jmysu/R3Mkr12F/README.md

# R3Mkr12F
Arduino R3 w/ MKR w/ ESP-12F VaporWare 

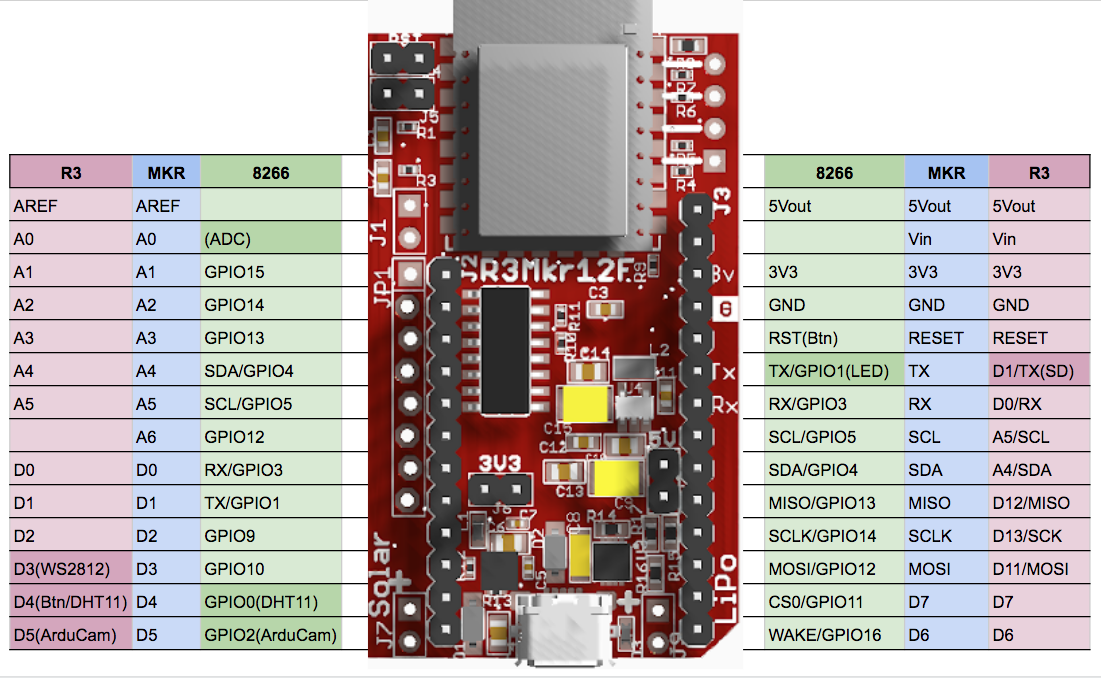
[picture p1: Documents/r3mkr12f_1.png]
R3Mkr12F Pinout

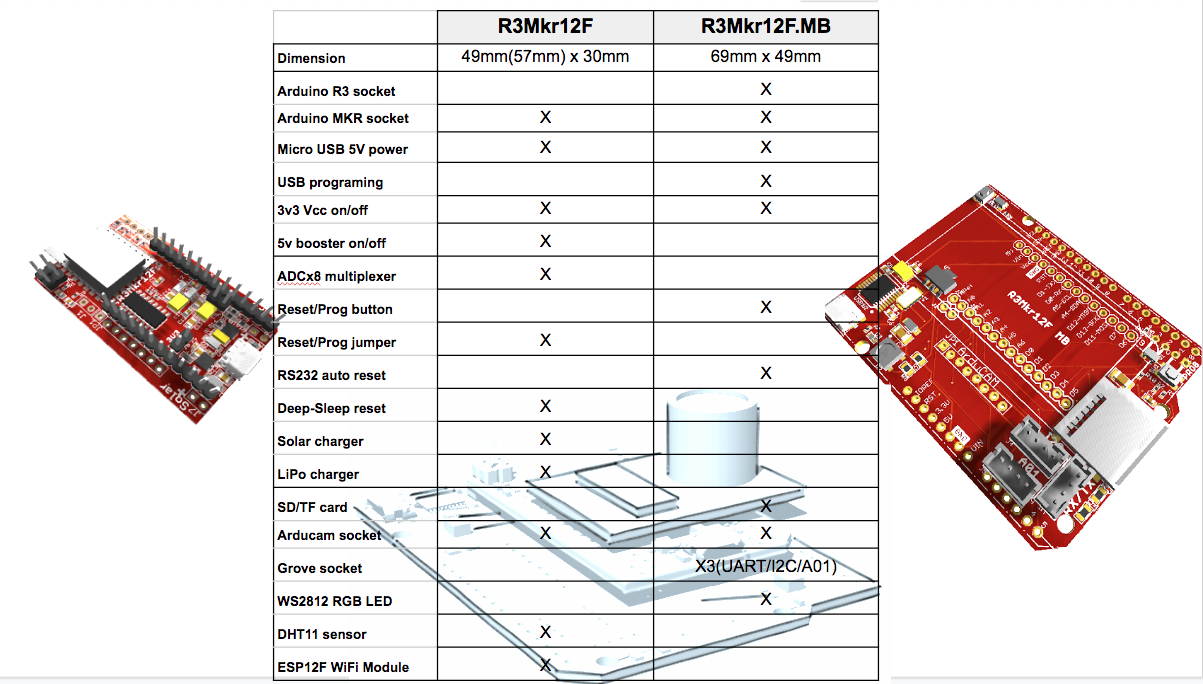
[picture p2: Documents/r3mkr12f_2.png]
R3Mkr12F Feature
