jmysu/R3Mkr12F/Hardware/DOC/SW4235.pdf

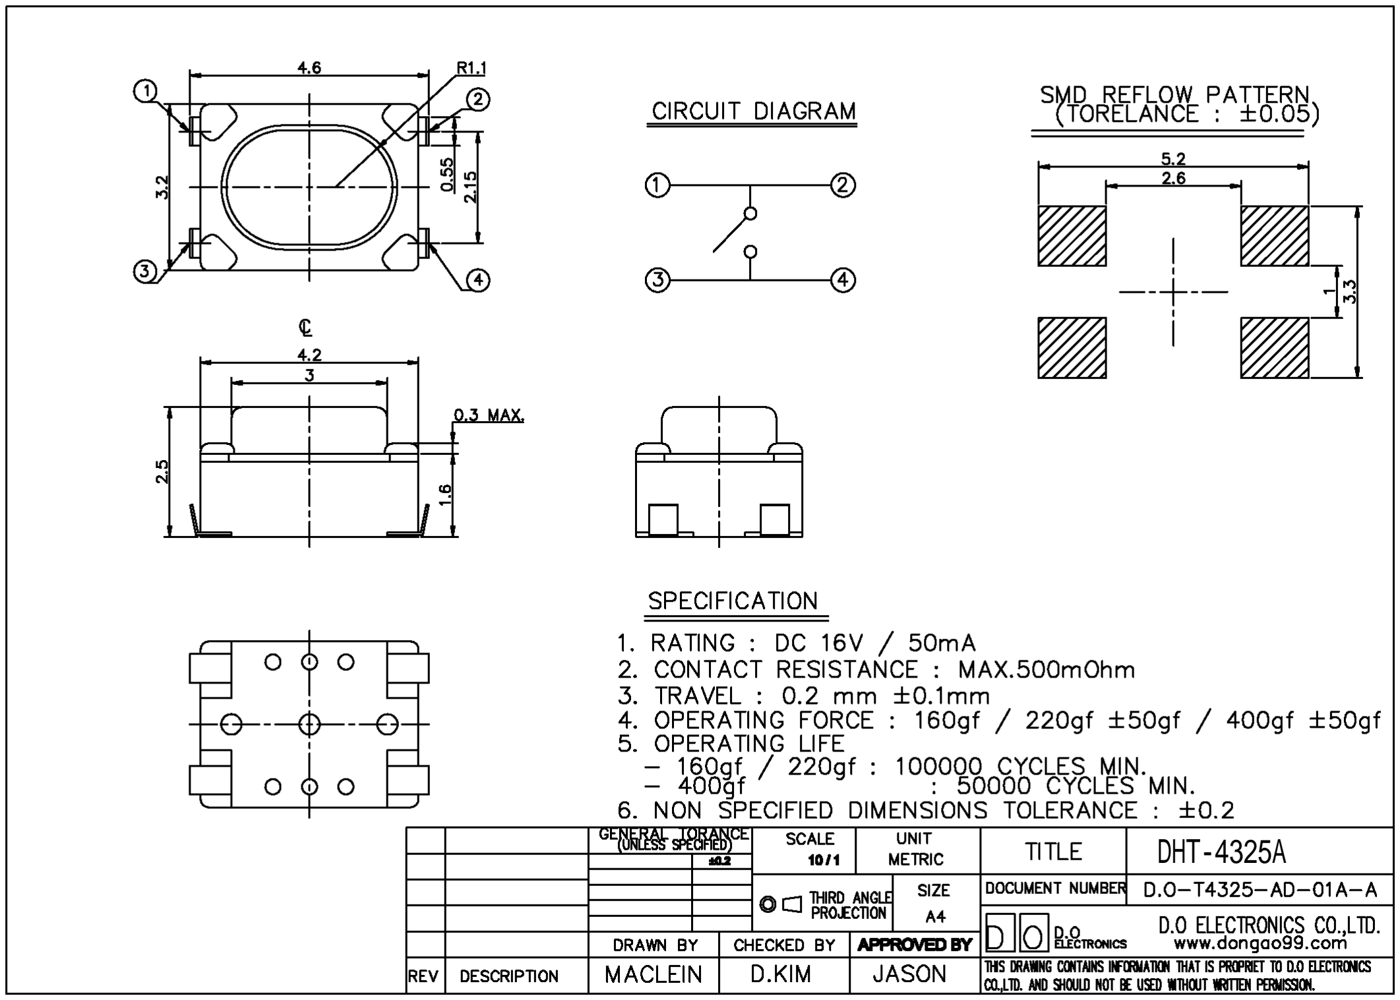
[picture p3: page 1]

REV I DESCRIPTlON

CIRCUIT DIAGRAM

SPECIFICATION
1. RATING : DC 16V / 50mA

SMD REFLOW PATTERN
CTORELANCE : :t0.051
2. CONTACT RESISTANCE : MAX.500mOhm
3. TRAVEL : 0.2
4. OPERA TI N G FORCE : 160gf / 220gf :t 50gf /
5. OPERATING Ll FE
I 220gf : 1 ' | - | : 50000 CYCLES MIN.
6. NON SPECIFIED DIMENSIONS TOLERANCE

DRAWN BY
MACLEIN
SCALE 1 | UNIT
1 METlRIC | TITLE
ANGLd | SIZE | T4325-AO-01 A-A
… | '
Ih 11"lno | D.O ELEClRONICS CO.,LlD.
BY I
D.K1M I JASON
