jmysu/R3Mkr12F/Hardware/DOC/R3Mkr12F_ArduCam.jpg

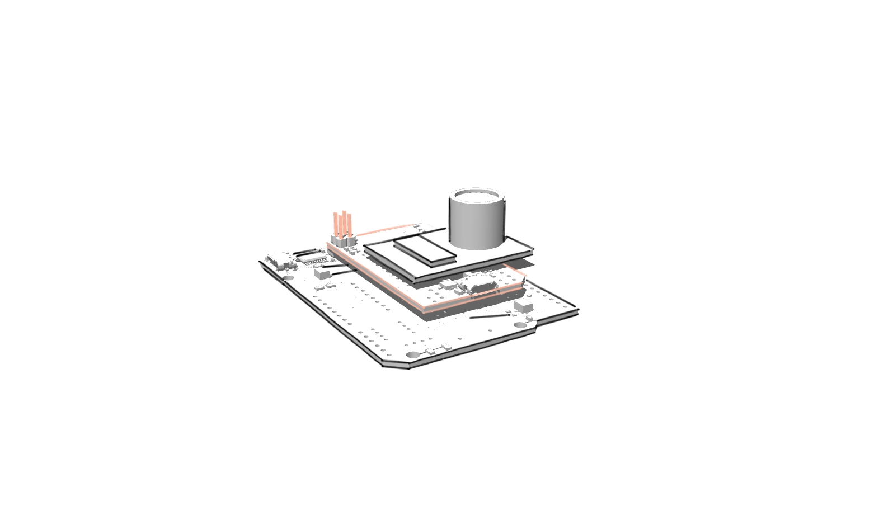
Hardware/DOC/R3Mkr12F_ArduCam.jpg
