jmysu/R3Mkr12F/Hardware/DOC/R3Mkr12F_MB_.png

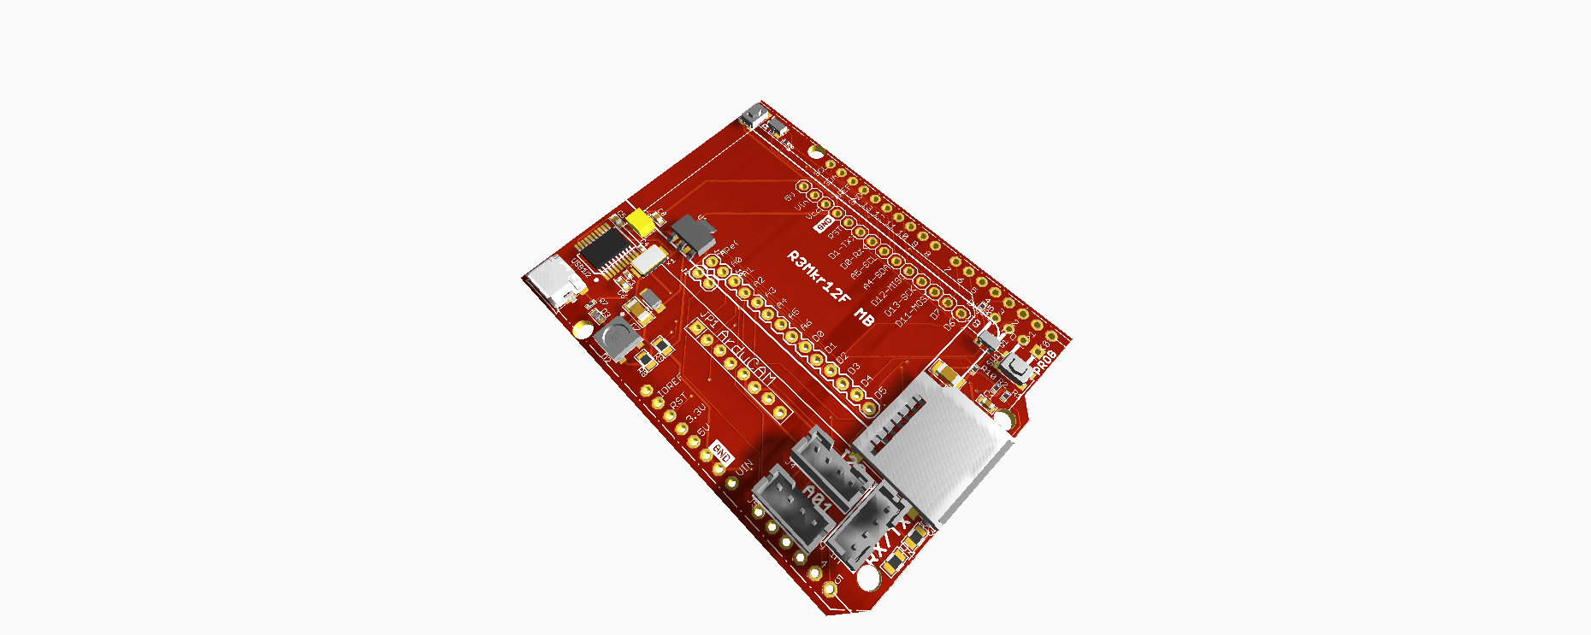
Hardware/DOC/R3Mkr12F_MB_.png
