jmysu/R3Mkr12F/Hardware/R3Mkr12F_Solar_Top.png

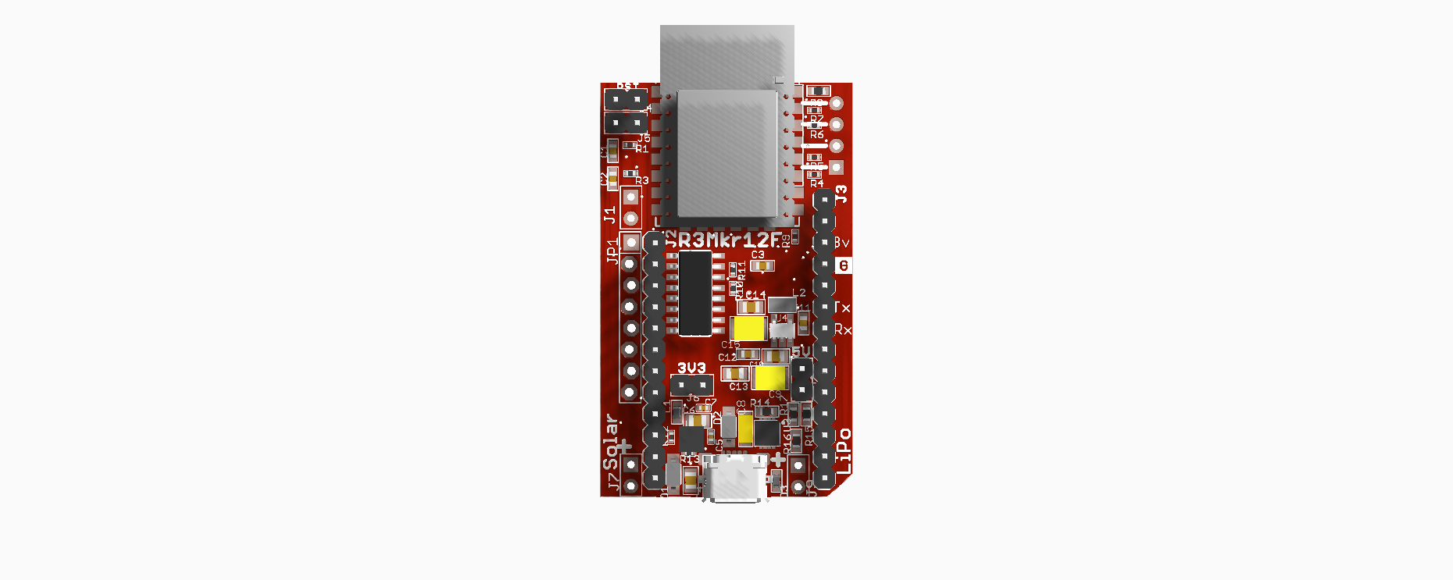
Hardware/R3Mkr12F_Solar_Top.png
