jmysu/R3Mkr12F/Hardware/DOC/dht22.stl

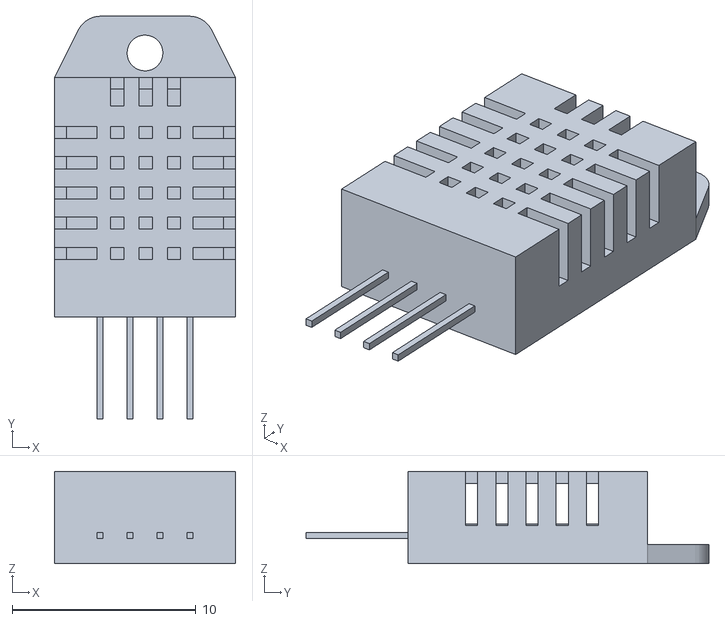
[picture p7: CAD file, 2019-06-03]
Hardware/DOC/dht22.stl
9.84 x 21.9 x 5.02
