jmysu/R3Mkr12F/Hardware/DOC/ArduCam.stl

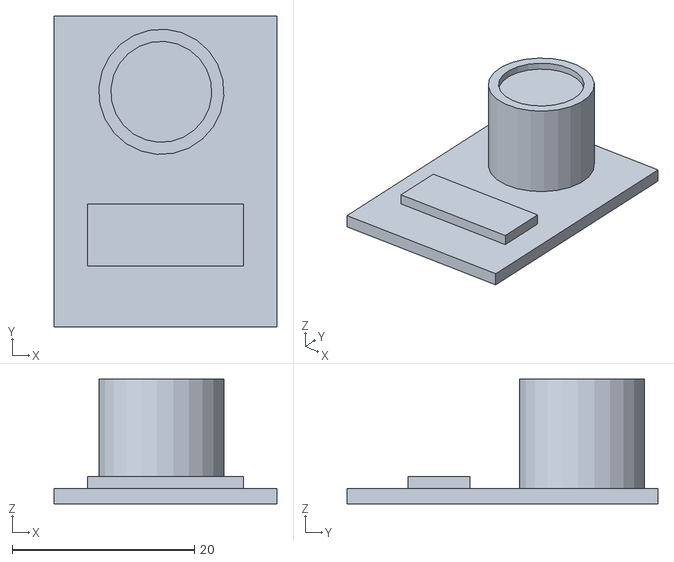
[picture p8: CAD file, 2019-06-03]
Hardware/DOC/ArduCam.stl
24.4 x 34.1 x 13.7
