jmysu/R3Mkr12F/(list of files, cad)

Other CAD files:
Hardware/DOC/R3Mkr12F_PV~.skp
