jmysu/R3Mkr12F/Hardware/R3Mkr12F_MB_.brd

## EAGLE design Hardware/R3Mkr12F_MB_.brd (2019-06-03)

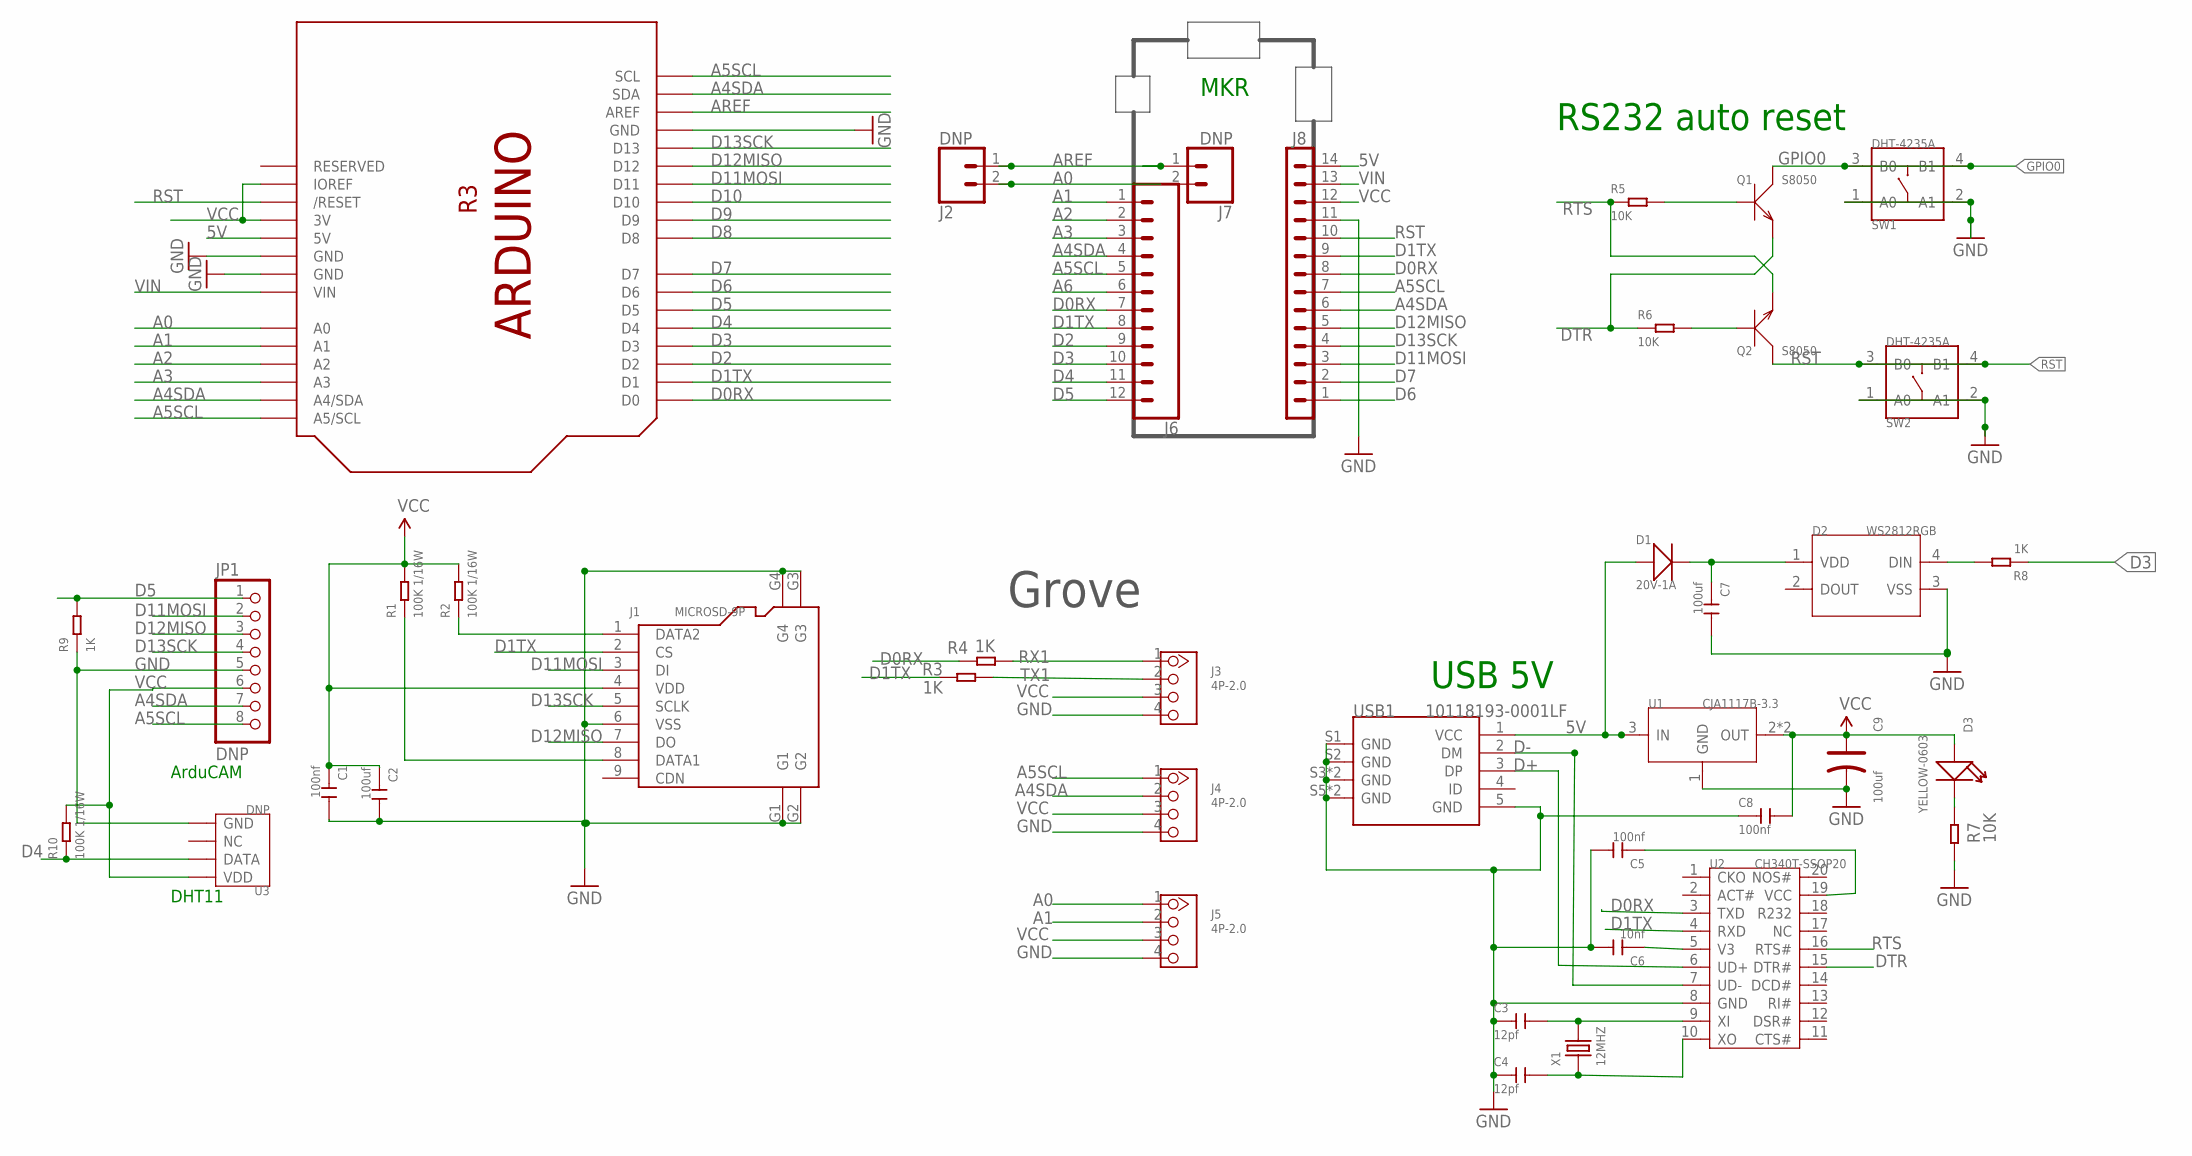
[picture p9: schematic R3Mkr12F_MB_.sch]

Parts:
C1, C5, C8: 100nf; C0603
C2, C7: 100uf; C1206
C3, C4: 12pf; C0402
C6: 10nf; C0603
C9: 100uf; AVX-B
D1: 20V-1A; SOD-123
D2: WS2812RGB; LED4-SMD-5050
D3: YELLOW-0603; LED-0603
J1: MICROSD-9P; MICRO-SD9+4P-SMD-16.1X14.5X1.85MM
J2, J7: DNP; 1X02
J3, J4, J5: 4P-2.0; HW4-2.0
J6: CONN_12LOCK; 1X12_LOCK
J8: DNP; 1X14
JP1: DNP; MILLER_1X08-LOCK
Q1, Q2: S8050; SOT-23
R1, R2, R10: 100K 1/16W; R0402
R3, R4, R8, R9: 1K; R0805
R5, R6, R7: 10K; R0402
SW1, SW2: DHT-4235A; SW4-SMD-4.2X3.2X2.5MM
U1: CJA1117B-3.3; SOT-89
U2: CH340T-SSOP20; SSOP20-0.65-7.6X5.2MM
U3: DNP; SNR4-2.54-15.5X12.0X5.5MM
UNO1: ARDUINO_R3_NOICSP_47MM; ARDUINOR3_NOICSP_47MM
USB1: 10118193-0001LF; MICRO-USB5+6P-SMD-0.65-B
X1: 12MHZ; X2-SMD-5.0X3.2X1.3MM

Connections:
5V: D1.+, J8.14, U1.3 (IN), UNO1.5V, USB1.1 (VCC)
A0: J2.2, J5.1, J7.2, UNO1.A0
A1: J5.2, J6.1, UNO1.A1
A2: J6.2, UNO1.A2
A3: J6.3, UNO1.A3
A4SDA: J4.2, J6.4, J8.6, JP1.7, UNO1.A4 (A4/SDA), UNO1.SDA
A5SCL: J4.1, J6.5, J8.7, JP1.8, UNO1.A5 (A5/SCL), UNO1.SCL
A6: J6.6
AREF: J2.1, J7.1, UNO1.AREF
D0RX: J6.7, J8.8, R4.2, U2.3 (TXD), UNO1.D0
D1TX: J1.2 (CS), J6.8, J8.9, R3.2, U2.4 (RXD), UNO1.D1
D2: J6.9, UNO1.D2
D3: J6.10, R8.1, UNO1.D3
D4: J6.11, R10.1, U3.2 (DATA), UNO1.D4
D5: J6.12, JP1.1, R9.2, UNO1.D5
D6: J8.1, UNO1.D6
D7: J8.2, UNO1.D7
D8: UNO1.D8
D9: UNO1.D9
D10: UNO1.D10
D11MOSI: J1.3 (DI), J8.3, JP1.2, UNO1.D11
D12MISO: J1.7 (DO), J8.5, JP1.3, UNO1.D12
D13SCK: J1.5 (SCLK), J8.4, JP1.4, UNO1.D13
D+: U2.6 (UD+), USB1.3 (DP)
D-: U2.7 (UD-), USB1.2 (DM)
DTR: Q1.2 (E), R6.1, U2.15 (DTR#)
GND: C1.2, C2.2, C3.1, C4.1, C5.2, C6.2, C7.2, C8.1, C9.-, D2.3 (VSS), J1.6 (VSS), J1.G1, J1.G2, J1.G3, J1.G4, J3.4, J4.4, J5.4, J8.11, JP1.5, R7.1, R9.1, SW1.1 (A0), SW1.2 (A1), SW2.1 (A0), SW2.2 (A1), U1.1 (GND), U2.8 (GND), U3.4 (GND), UNO1.GND, UNO1.GND@1 (GND), UNO1.GND@2 (GND), USB1.5 (GND), USB1.S1 (GND), USB1.S2 (GND), USB1.S3 (GND), USB1.S4 (GND), USB1.S5 (GND), USB1.S6 (GND)
GPIO0: Q1.3 (C), SW1.3 (B0), SW1.4 (B1)
unnamed: C3.2, U2.9 (XI), X1.2
unnamed: C4.2, U2.10 (XO), X1.1
unnamed: J1.8 (DATA1), R1.1
unnamed: J1.1 (DATA2), R2.1
unnamed: D2.4 (DIN), R8.2
unnamed: Q2.1 (B), R6.2
unnamed: Q1.1 (B), R5.2
unnamed: D3.-, R7.2
RST: J8.10, Q2.3 (C), SW2.3 (B0), SW2.4 (B1), UNO1.RESET (/RESET)
RTS: Q2.2 (E), R5.1, U2.16 (RTS#)
RX1: J3.1, R4.1
TX1: J3.2, R3.1
V1: C7.1, D1.-, D2.1 (VDD)
V3: C6.1, U2.5 (V3)
VCC: C1.1, C2.1, C5.1, C8.2, C9.+, D3.+, J1.4 (VDD), J3.3, J4.3, J5.3, J8.12, JP1.6, R1.2, R2.2, R10.2, U1.2 (OUT), U1.4 (OUT), U2.19 (VCC), U3.1 (VDD), UNO1.3V, UNO1.IOREF
VIN: J8.13, UNO1.VIN

Notes on the sheet:
Grove
USB 5V
RS232 auto reset
DHT11
ArduCAM
MKR

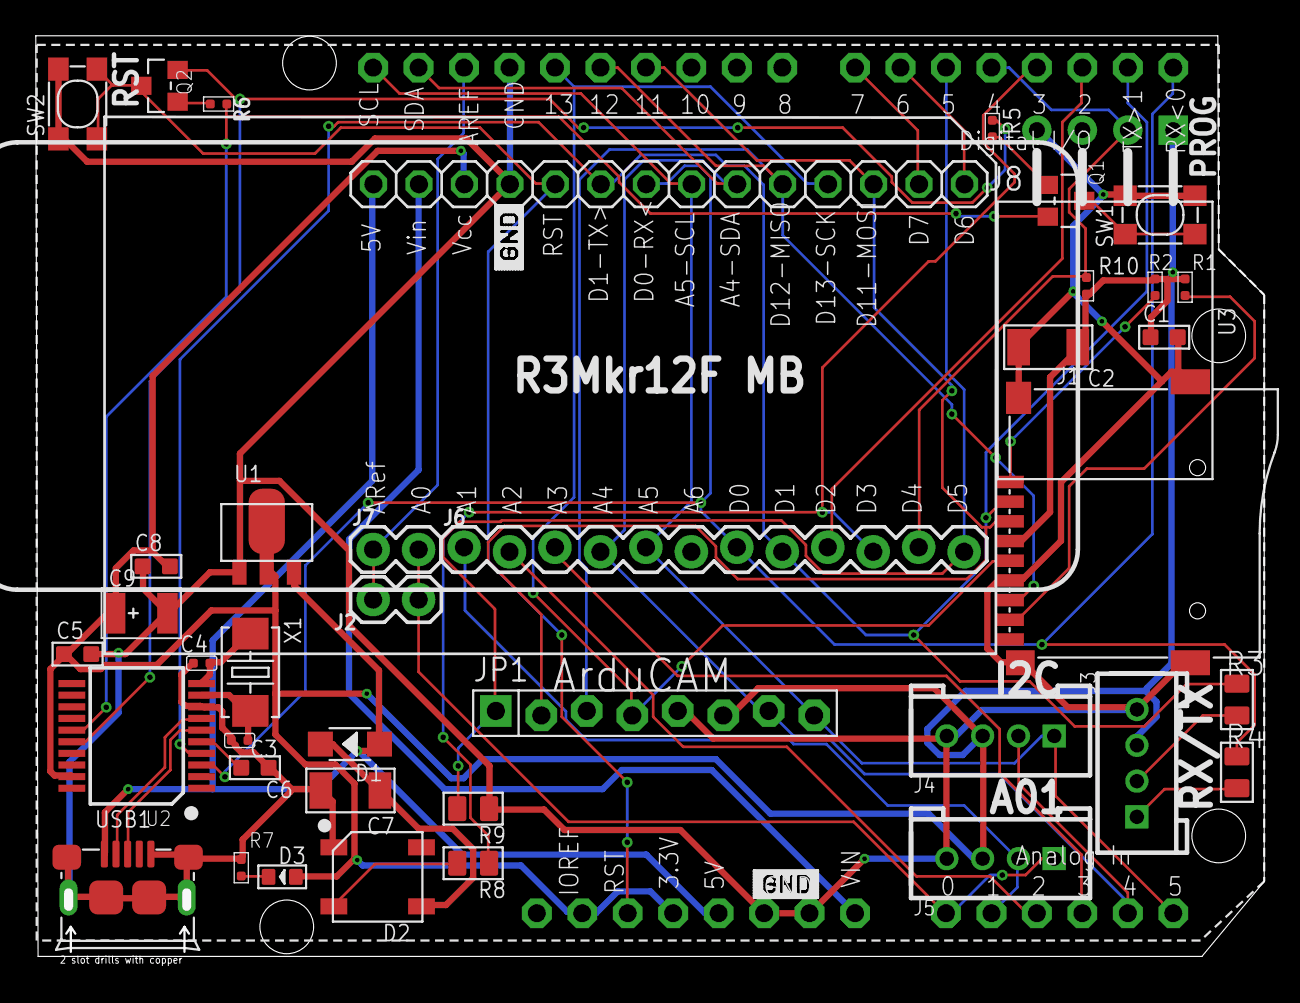
[picture p10: board R3Mkr12F_MB_.brd from above]

Board: 2 copper layers, 68.6 x 51.4 mm, 41 parts (0 on the bottom side), 40 nets.
