jmysu/R3Mkr12F/Hardware/R3Mkr12F_Solar.brd

## EAGLE design Hardware/R3Mkr12F_Solar.brd (2019-06-03)

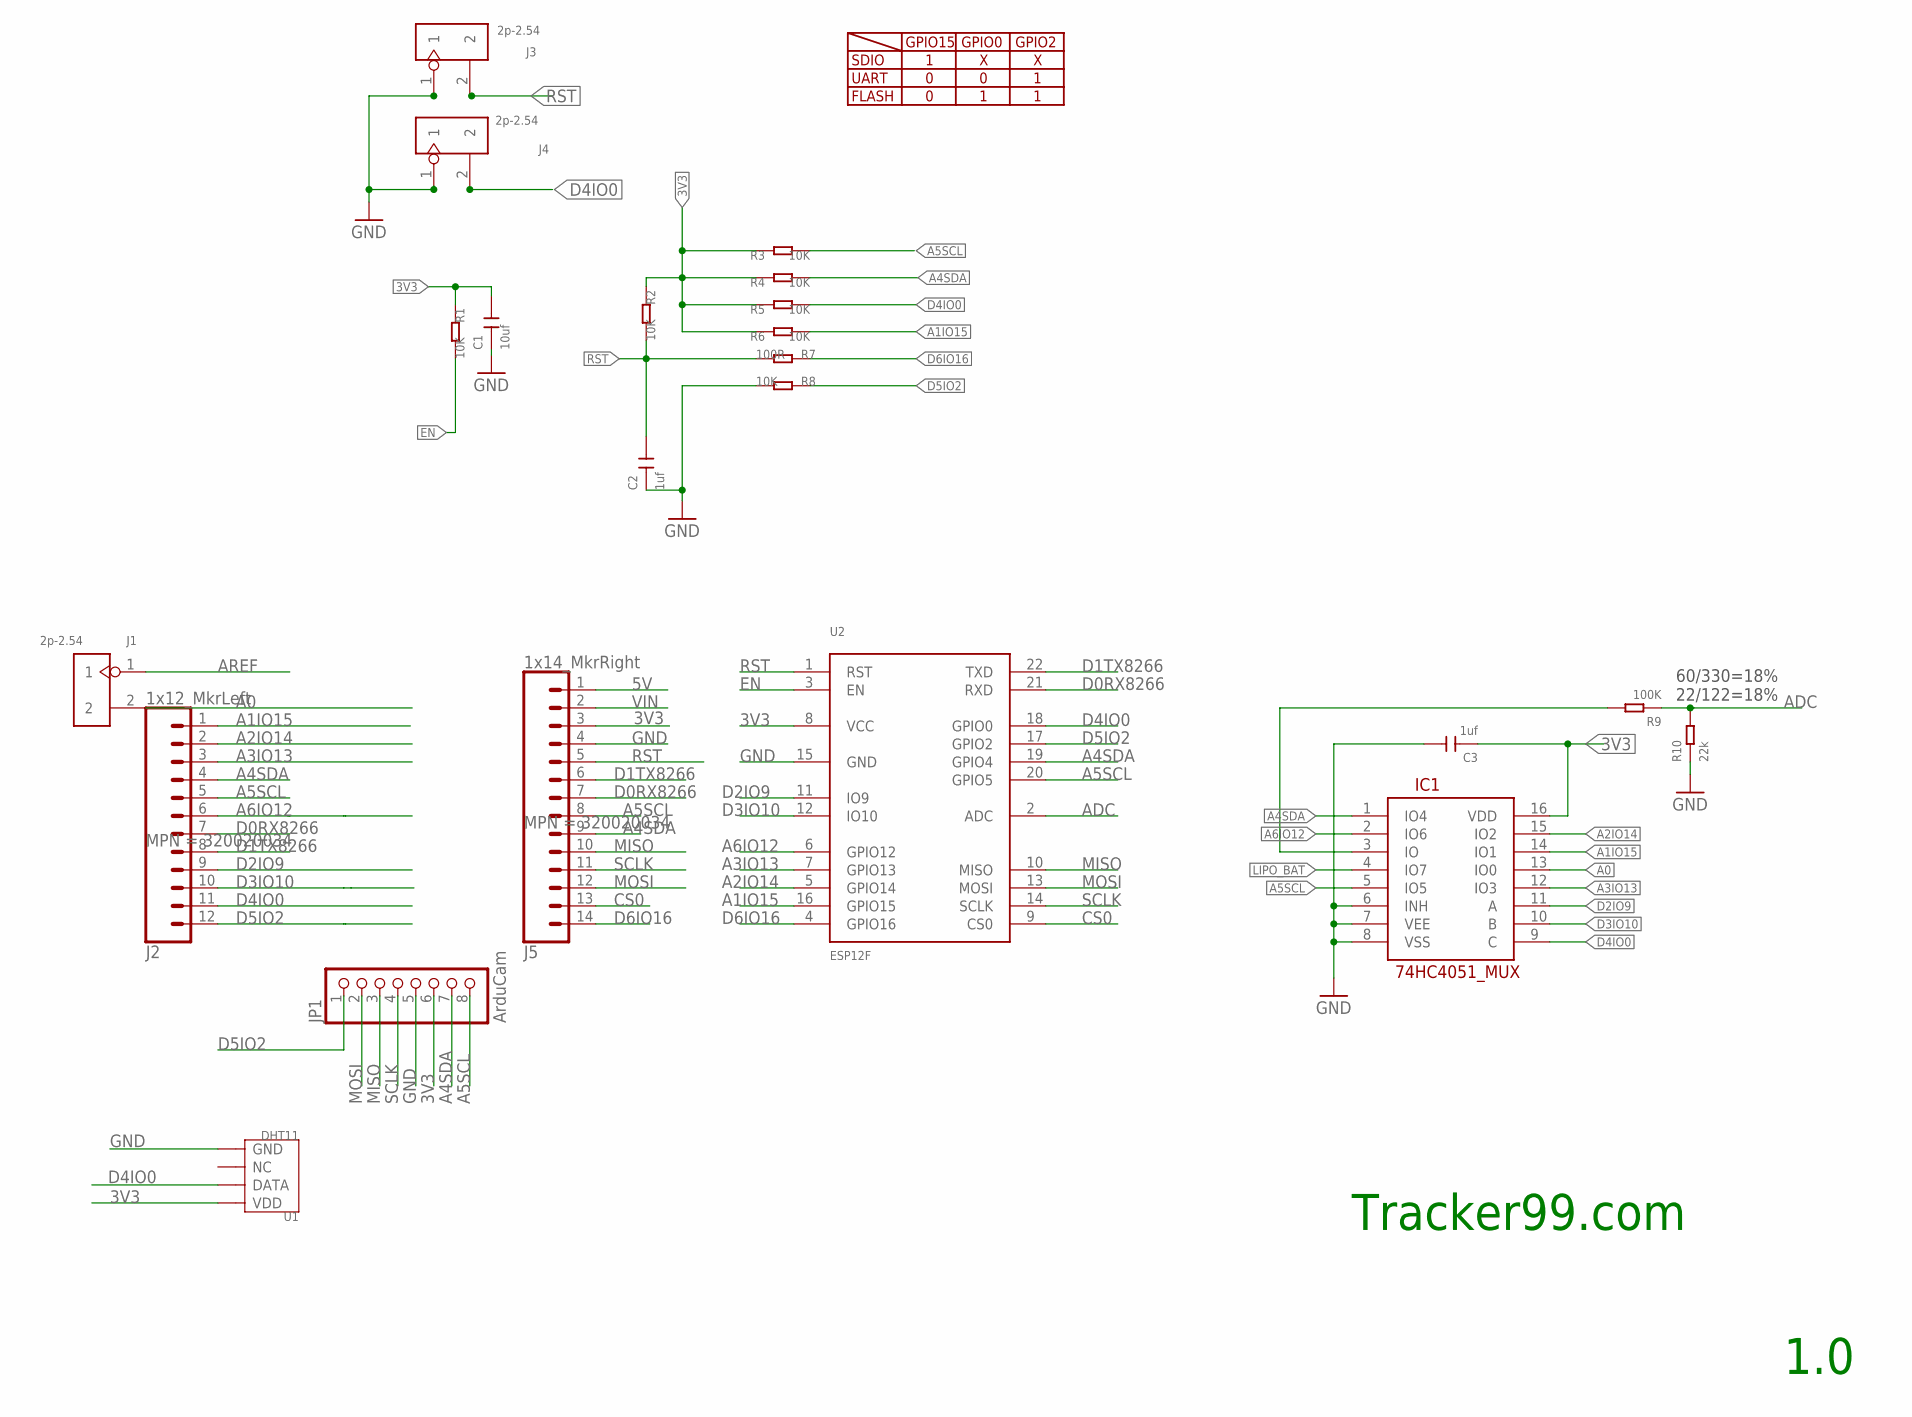
[picture p11: schematic R3Mkr12F_Solar.sch, sheet 1]

Parts:
C1: 10uf; C0603
C2, C3: 1uf; C0603
IC1: 74HC4051_MUX; SPARKFUN_SO16
J1, J3, J4: 2p-2.54; H2-2.54
J2: 1x12_MkrLeft; 1X12_LOCK; MPN 320020034
J5: 1x14_MkrRight; 1X14_LOCK; MPN 320020034
JP1: ArduCam; MILLER_1X08-LOCK
R1, R2, R3, R4, R5, R6, R8: 10K; SEEED-RESISTOR_R0402
R7: 100R; R0603
R9: 100K; R0402
R10: 22k; R0402
U1: DHT11; SNR4-2.54-15.5X12.0X5.5MM
U2: ESP12F; ESP-12F

Connections:
3V3: C1.2, C3.1, IC1.16 (VDD), J5.3, JP1.6, R1.1, R2.1, R3.1, R4.1, R5.1, R6.1, U1.1 (VDD), U2.8 (VCC); also elsewhere on the board
5V: J5.1; also elsewhere on the board
A0: IC1.13 (IO0), J1.2
A1IO15: IC1.14 (IO1), J2.1, R6.2, U2.16 (GPIO15)
A2IO14: IC1.15 (IO2), J2.2, U2.5 (GPIO14)
A3IO13: IC1.12 (IO3), J2.3, U2.7 (GPIO13)
A4SDA: IC1.1 (IO4), J2.4, J5.9, JP1.7, R4.2, U2.19 (GPIO4)
A5SCL: IC1.5 (IO5), J2.5, J5.8, JP1.8, R3.2, U2.20 (GPIO5)
A6IO12: IC1.2 (IO6), J2.6, U2.6 (GPIO12)
ADC: R9.1, R10.2, U2.2 (ADC)
AREF: J1.1
CS0: J5.13, U2.9 (CS0)
D0RX8266: J2.7, J5.7, U2.21 (RXD)
D1TX8266: J2.8, J5.6, U2.22 (TXD)
D2IO9: IC1.11 (A), J2.9, U2.11 (IO9)
D3IO10: IC1.10 (B), J2.10, U2.12 (IO10)
D4IO0: IC1.9 (C), J2.11, J4.2, R5.2, U1.2 (DATA), U2.18 (GPIO0)
D5IO2: J2.12, JP1.1, R8.1, U2.17 (GPIO2)
D6IO16: J5.14, R7.1, U2.4 (GPIO16)
EN: R1.2, U2.3 (EN)
GND: C1.1, C2.1, C3.2, IC1.6 (INH), IC1.7 (VEE), IC1.8 (VSS), J3.1, J4.1, J5.4, JP1.5, R8.2, R10.1, U1.4 (GND), U2.15 (GND); also elsewhere on the board
LIPO_BAT: IC1.4 (IO7); also elsewhere on the board
MISO: J5.10, JP1.3, U2.10 (MISO)
MOSI: J5.12, JP1.2, U2.13 (MOSI)
RST: C2.2, J3.2, J5.5, R2.2, R7.2, U2.1 (RST)
SCLK: J5.11, JP1.4, U2.14 (SCLK)
VIN: J5.2
Z: IC1.3 (IO), R9.2

Notes on the sheet:
SDIO
UART
FLASH
GPIO15
GPIO0
GPIO2
60/330=18% 22/122=18%
Tracker99.com
1.0

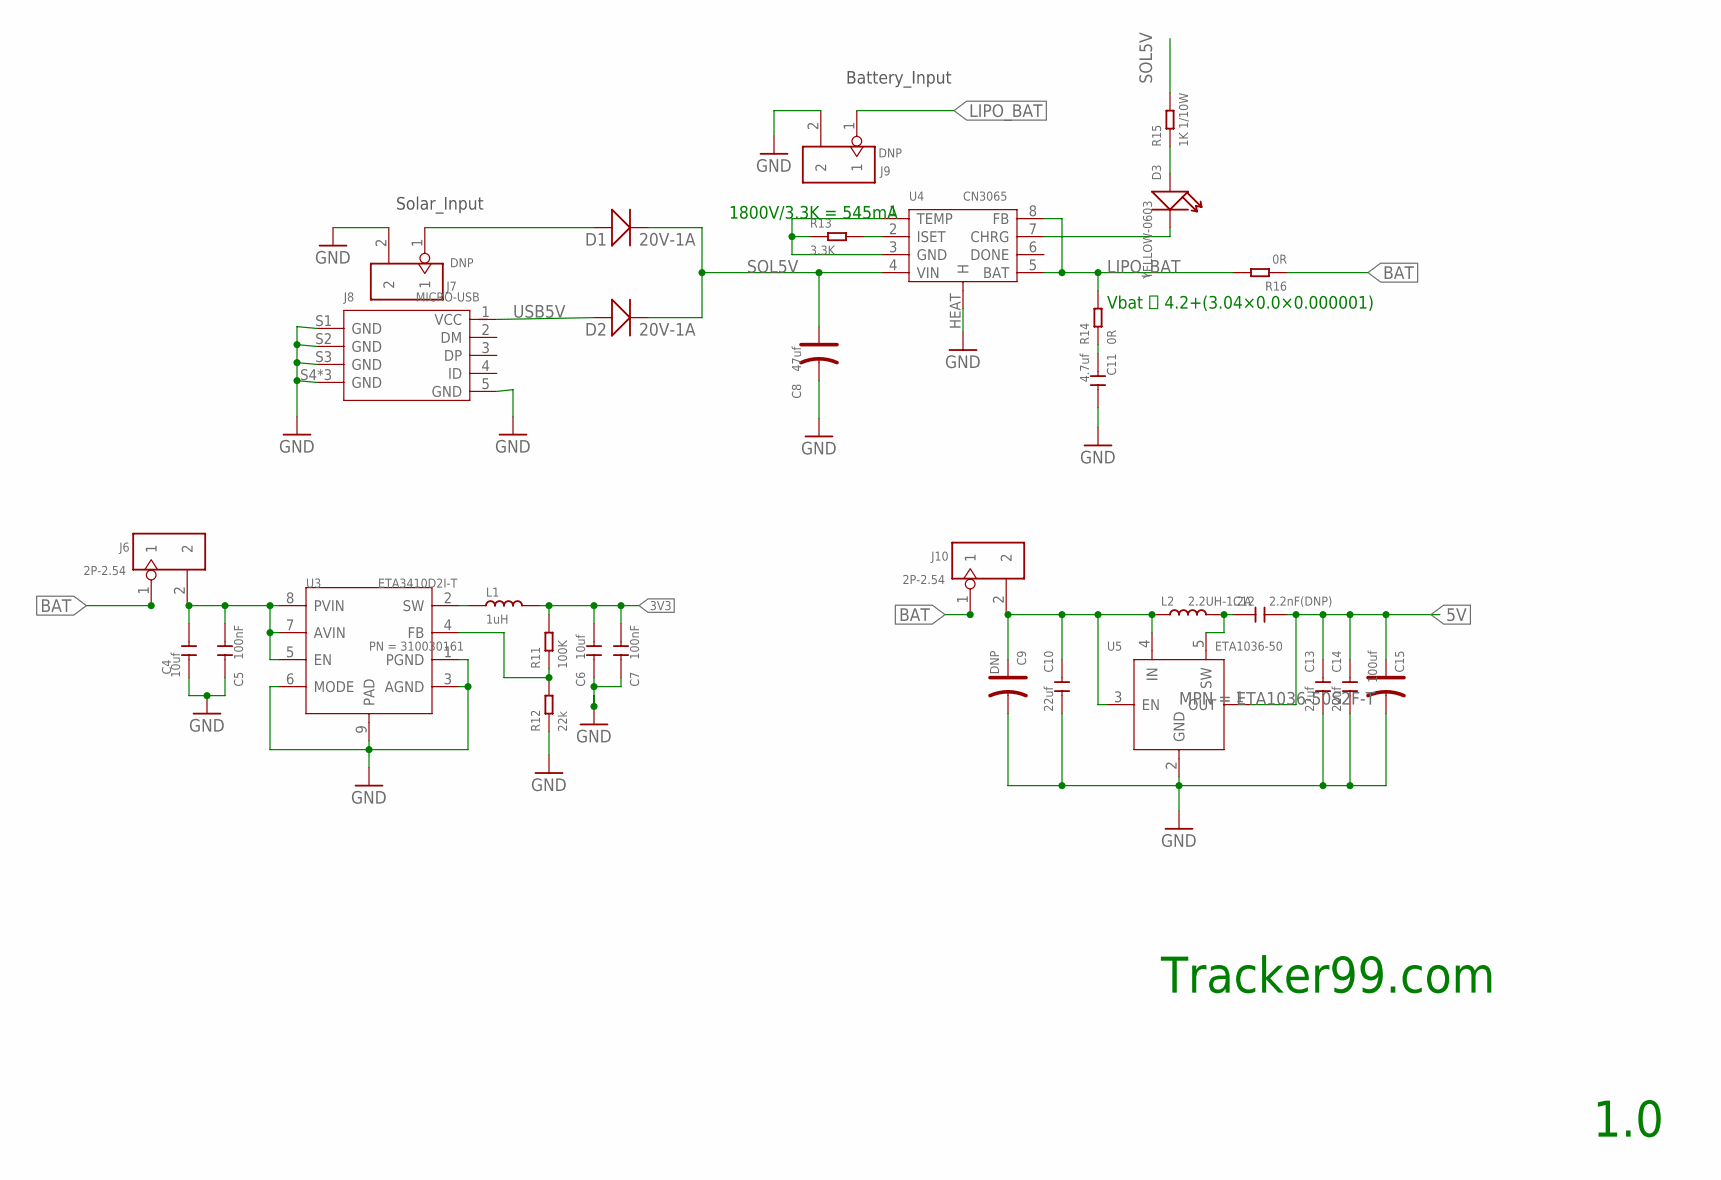
[picture p12: schematic R3Mkr12F_Solar.sch, sheet 2]

Parts:
C4, C6: 10uf; C0805
C5, C7: 100nF; C0402
C8: 47uf; AVX-A
C9: DNP; AVX-B
C10, C13, C14: 22uf; C0805
C11: 4.7uf; C0603
C12: 2.2nF(DNP); C0603
C15: 100uf; AVX-B
D1, D2: 20V-1A; SOD-123
D3: YELLOW-0603; LED-0603
J6, J10: 2P-2.54; H2-2.54
J7, J9: DNP; H2-2.54
J8: MICRO-USB; MICRO-USB5+4P-SMD-0.65-B
L1: 1uH; L0603
L2: 2.2UH-1.2A; L0805
R11: 100K; R0402
R12: 22k; R0402
R13: 3.3K; R0603
R14, R16: 0R; R0603
R15: 1K 1/10W; R0603
U3: ETA3410D2I-T; DFN8G-0.5-2X2MM
U4: CN3065; DFN-8
U5: ETA1036-50; SOT23-5; MPN ETA1036-50S2F-T

Connections:
3V3: C6.2, C7.2, L1.2, R11.2; also elsewhere on the board
5V: C12.2, C13.1, C14.1, C15.+, U5.1 (OUT); also elsewhere on the board
BAT: J6.1, J10.1, R16.1
BAT_3V3_IN: C4.2, C5.2, J6.2, U3.5 (EN), U3.7 (AVIN), U3.8 (PVIN)
BAT_IN: C9.+, C10.1, J10.2, L2.1, U5.3 (EN), U5.4 (IN)
GND: C4.1, C5.1, C6.1, C7.1, C8.-, C9.-, C10.2, C11.2, C13.2, C14.2, C15.-, J7.2, J8.5 (GND), J8.S1 (GND), J8.S2 (GND), J8.S3 (GND), J8.S4 (GND), J8.S5 (GND), J8.S6 (GND), J9.2, R12.1, R13.1, U3.1 (PGND), U3.3 (AGND), U3.6 (MODE), U3.9 (PAD), U4.1 (TEMP), U4.3 (GND), U4.HEAT (H), U5.2 (GND); also elsewhere on the board
LIPO_BAT: J9.1, R14.2, R16.2, U4.5 (BAT), U4.8 (FB); also elsewhere on the board
unnamed: D1.+, J7.1
unnamed: D3.+, R15.1
unnamed: L1.1, U3.2 (SW)
unnamed: R11.1, R12.2, U3.4 (FB)
unnamed: R13.2, U4.2 (ISET)
unnamed: D3.-, U4.7 (CHRG)
unnamed: C11.1, R14.1
unnamed: C12.1, L2.2, U5.5 (SW)
SOL5V: C8.+, D1.-, D2.-, R15.2, U4.4 (VIN)
USB5V: D2.+, J8.1 (VCC)

Notes on the sheet:
Solar_Input
Battery_Input
Vbat ＝ 4.2+(3.04×0.0×0.000001)
1800V/3.3K = 545mA
Tracker99.com
1.0

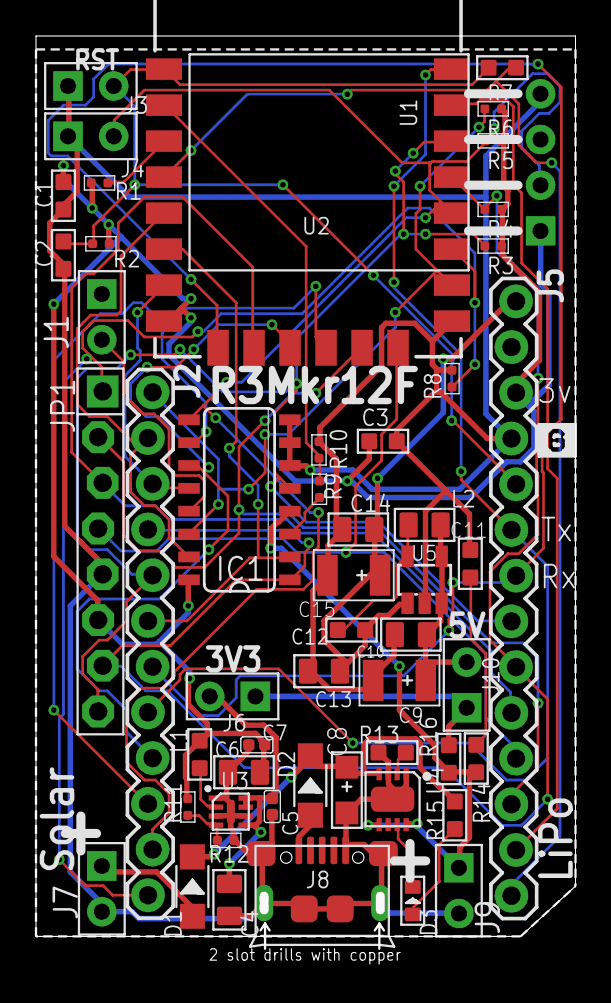
[picture p13: board R3Mkr12F_Solar.brd from above]

Board: 2 copper layers, 30.0 x 50.7 mm, 53 parts (0 on the bottom side), 39 nets.
